redfescue/Strandbeest/strand2.jpg

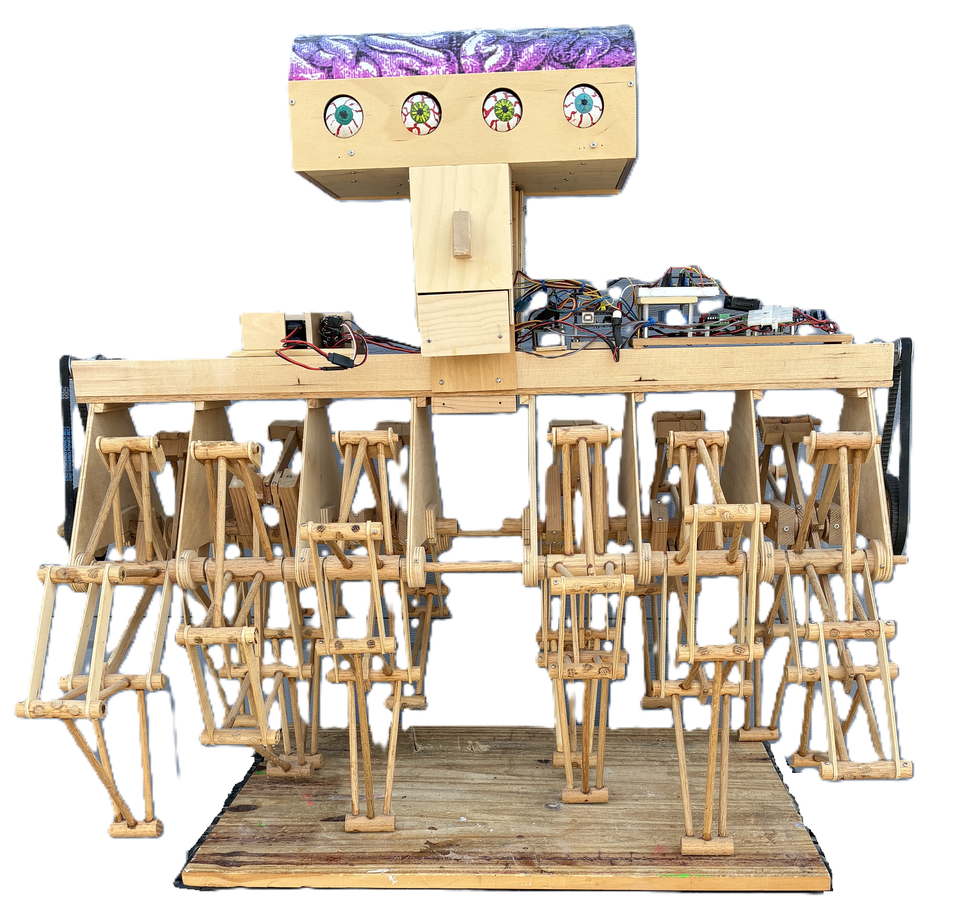
strand2.jpg
