redfescue/Strandbeest/README.md

Arduino-controlled motorized Strandbeest project documents. 
Refer to the Arduino Project Hub in the "Robotics" category.
Motorized strandbeest with disembodied brain floating in nutrient bath. Includes 7 rotating eyeballs.
Also makes sounds - rooster, cow, and alien from "Mars Attacks" AcK! Ack!
