redfescue/Strandbeest/(commit log)

2026-05-04 Add project description to README
    For Arduino Project Hub
2026-05-11 Update README with project description
    Added project description for Arduino-controlled Strandbeest.
2026-06-13 Update README to specify Robotics category for Arduino
    Clarify reference to the Arduino Project Hub category.
